vilmantasbaranauskas/n3d-crossed-cantilever-3d-printer/3d-models/README.md

### 3D Printable Models

This directory contains the 3D model files (`.3mf`) required to assemble the N3D Crossed-Cantilever 3D printer.

You will need a printer with a build plate of at least **220 × 220 mm** to print the parts.

### Gantry Configuration Options

The gantry component is provided in two options to accommodate different printer build volumes and user preferences. The minimum required bed size for printing the gantry as a single part is around **242 × 242 mm**.

* **Single Part:** `gantry-as-one-part.3mf`
* **Split into 3 Parts:** `gantry-left.3mf`, `gantry-center.3mf` and `gantry-right.3mf`
