vilmantasbaranauskas/n3d-crossed-cantilever-3d-printer/3d-models/timing-belt-holder-bottom.3mf

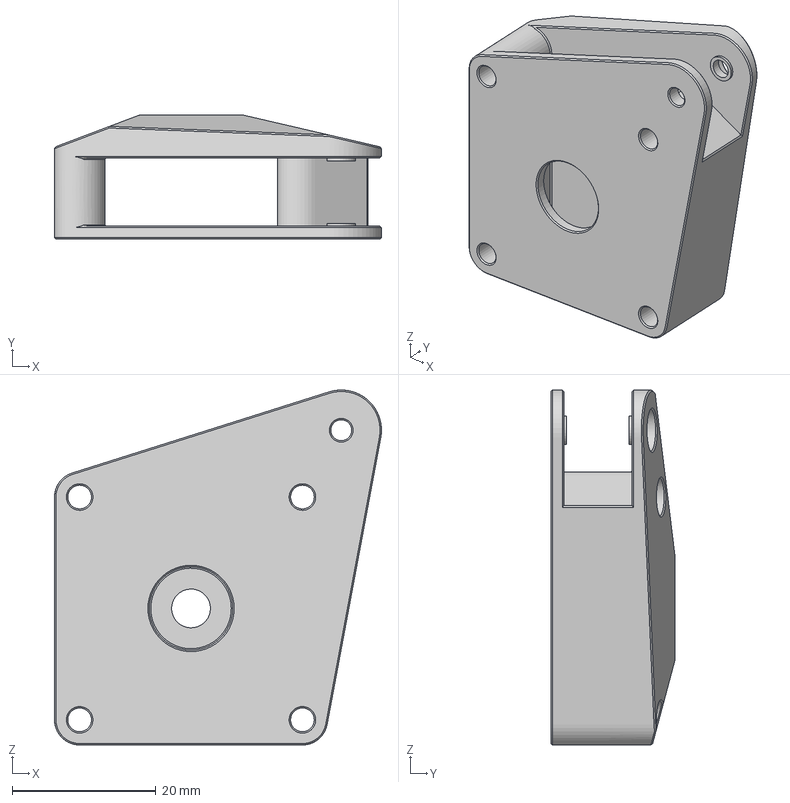
[picture p1: CAD file, 2026-11-01]
3d-models/timing-belt-holder-bottom.3mf
45.5 x 17.3 x 49.4 mm
