vilmantasbaranauskas/n3d-crossed-cantilever-3d-printer/cad/print-block.step

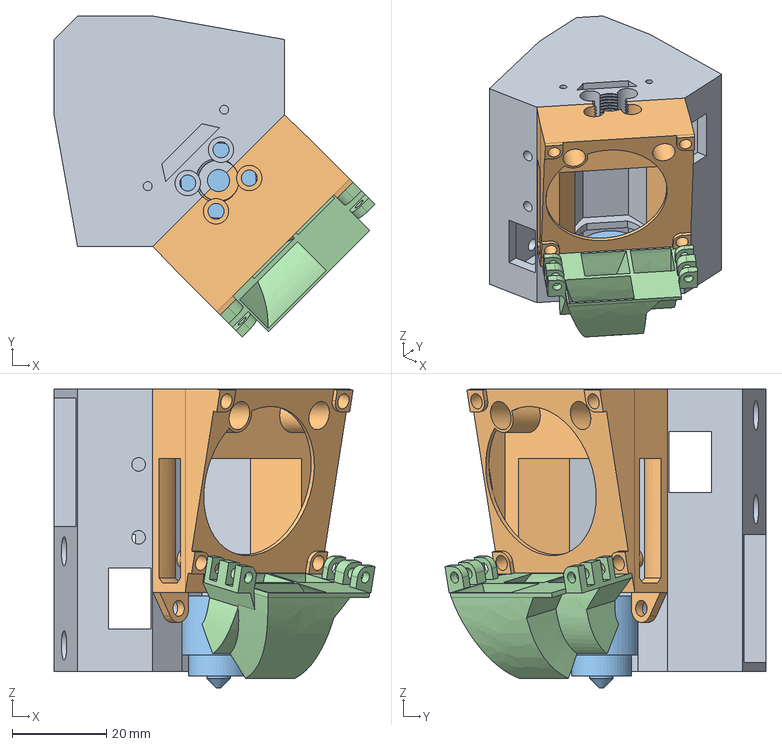
[picture p2: CAD file, 2026-10-28]
cad/print-block.step
68.3 x 68.3 x 63.5 mm
