vilmantasbaranauskas/n3d-crossed-cantilever-3d-printer/3d-models/gantry-as-one-part.3mf

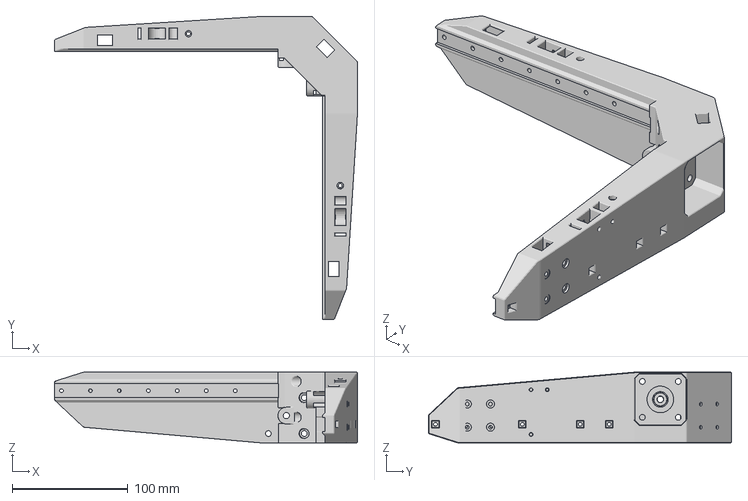
[picture p3: CAD file, 2026-10-28]
3d-models/gantry-as-one-part.3mf
261.5 x 261.5 x 61.0 mm
