vilmantasbaranauskas/n3d-crossed-cantilever-3d-printer/3d-models/belt-tensioner.3mf

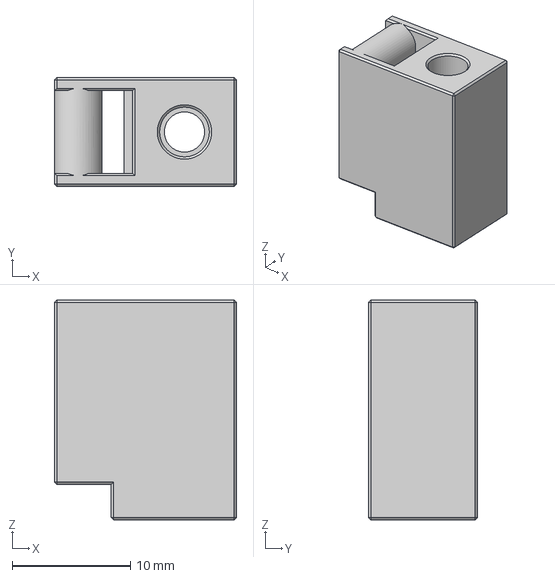
[picture p4: CAD file, 2026-10-28]
3d-models/belt-tensioner.3mf
15.4 x 9.20 x 18.6 mm
