vilmantasbaranauskas/n3d-crossed-cantilever-3d-printer/3d-models/m3-damper.3mf

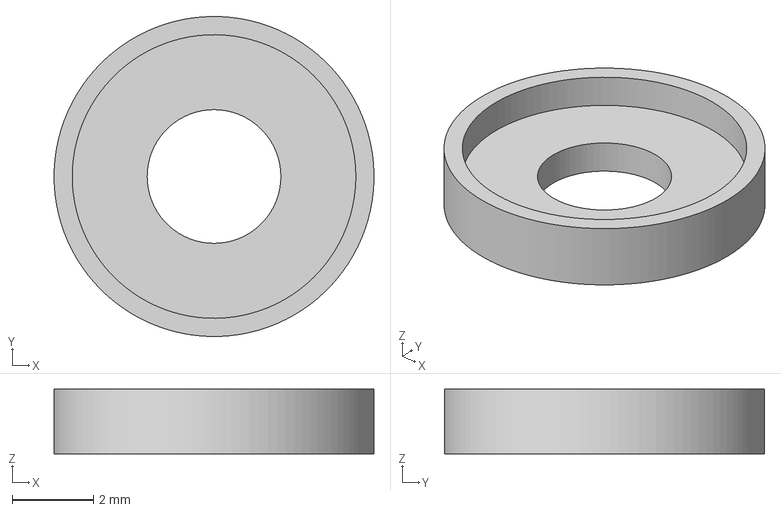
[picture p5: CAD file, 2026-10-28]
3d-models/m3-damper.3mf
7.90 x 7.90 x 1.60 mm
