vilmantasbaranauskas/n3d-crossed-cantilever-3d-printer/3d-models/gantry-left.3mf

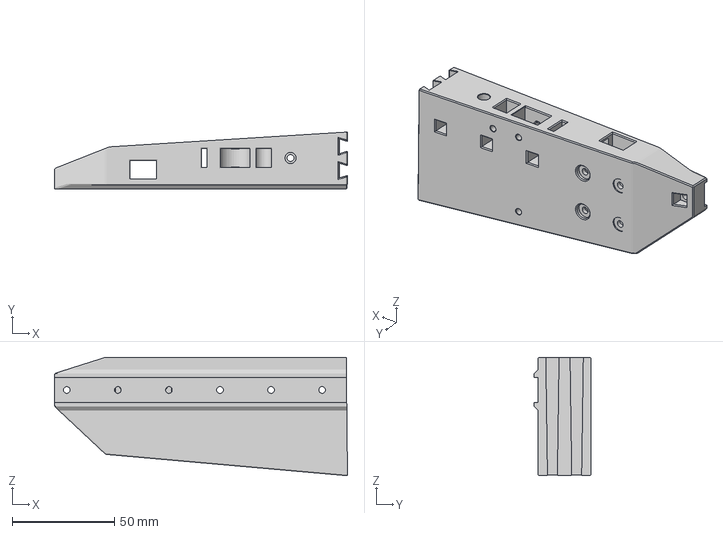
[picture p6: CAD file, 2026-10-28]
3d-models/gantry-left.3mf
143.4 x 27.9 x 58.0 mm
