vilmantasbaranauskas/n3d-crossed-cantilever-3d-printer/3d-models/gantry-center.3mf

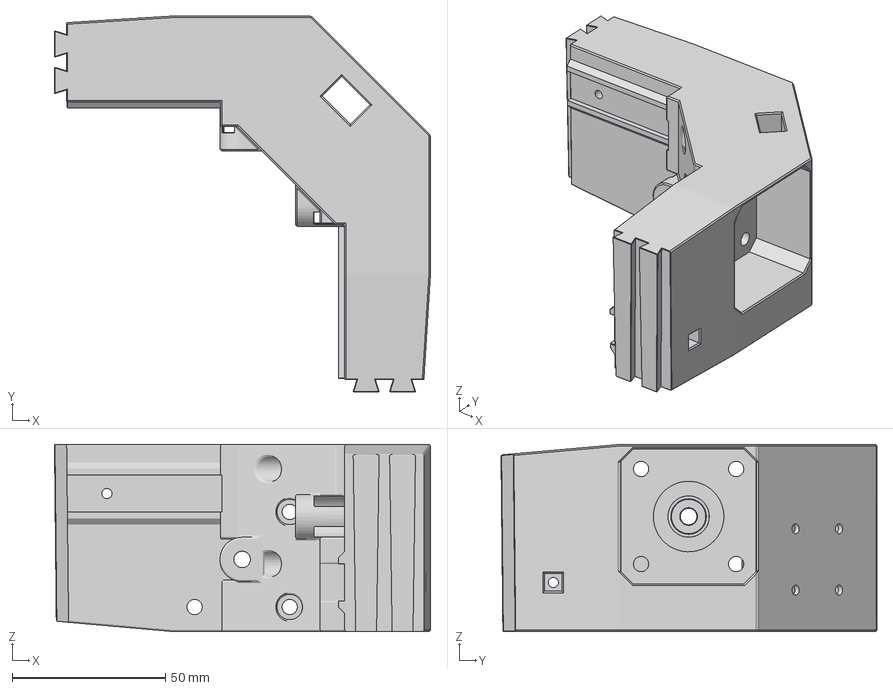
[picture p7: CAD file, 2026-10-28]
3d-models/gantry-center.3mf
122.6 x 122.6 x 61.0 mm
