vilmantasbaranauskas/n3d-crossed-cantilever-3d-printer/3d-models/hotbed-adapter.3mf

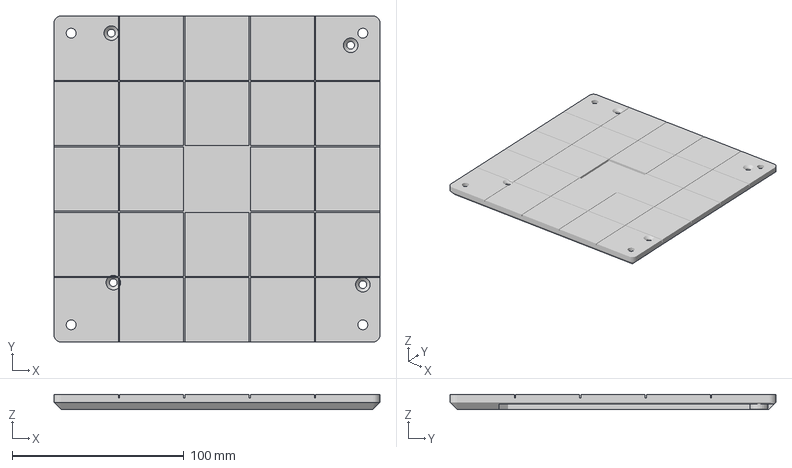
[picture p8: CAD file, 2026-10-28]
3d-models/hotbed-adapter.3mf
190.0 x 190.0 x 8.50 mm
