vilmantasbaranauskas/n3d-crossed-cantilever-3d-printer/3d-models/belt-tensioner-plug.3mf

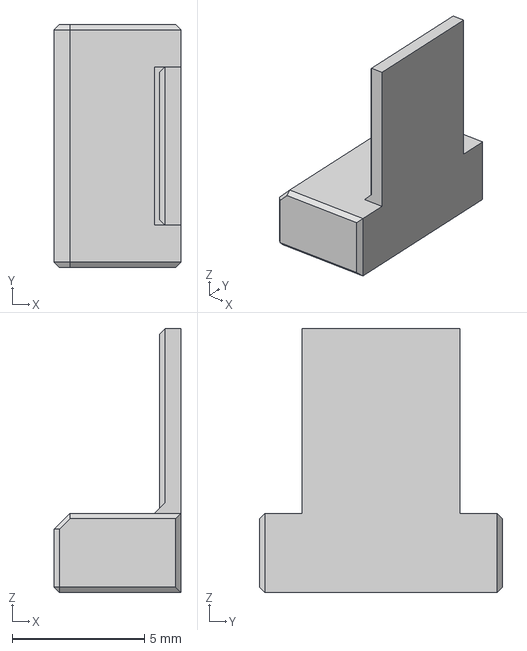
[picture p9: CAD file, 2026-10-28]
3d-models/belt-tensioner-plug.3mf
4.80 x 9.20 x 10.0 mm
