vilmantasbaranauskas/n3d-crossed-cantilever-3d-printer/3d-models/cover.3mf

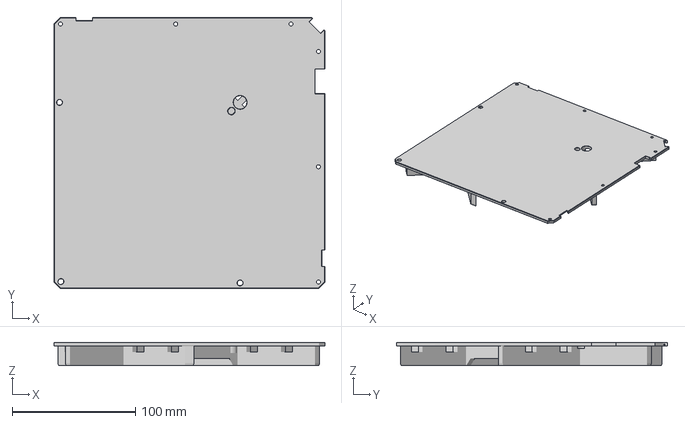
[picture p10: CAD file, 2026-10-28]
3d-models/cover.3mf
220.0 x 220.0 x 19.0 mm
