vilmantasbaranauskas/n3d-crossed-cantilever-3d-printer/3d-models/fan-damper.3mf

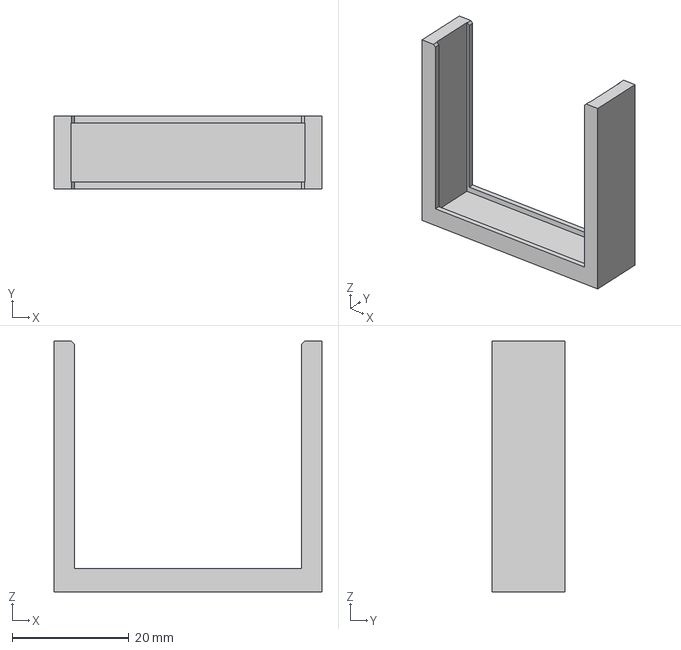
[picture p11: CAD file, 2026-10-28]
3d-models/fan-damper.3mf
46.0 x 12.5 x 43.0 mm
