vilmantasbaranauskas/n3d-crossed-cantilever-3d-printer/3d-models/transformer-holder.3mf

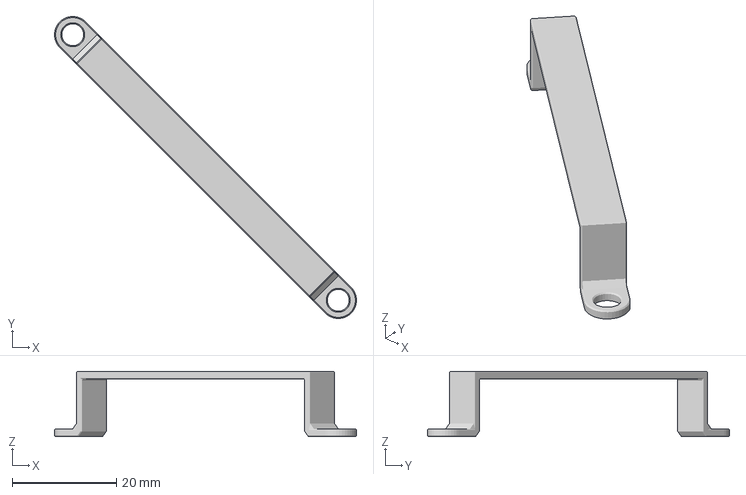
[picture p12: CAD file, 2026-10-28]
3d-models/transformer-holder.3mf
57.9 x 57.9 x 12.5 mm
