vilmantasbaranauskas/n3d-crossed-cantilever-3d-printer/3d-models/print-block-front-for-e3d-revo-voron.3mf

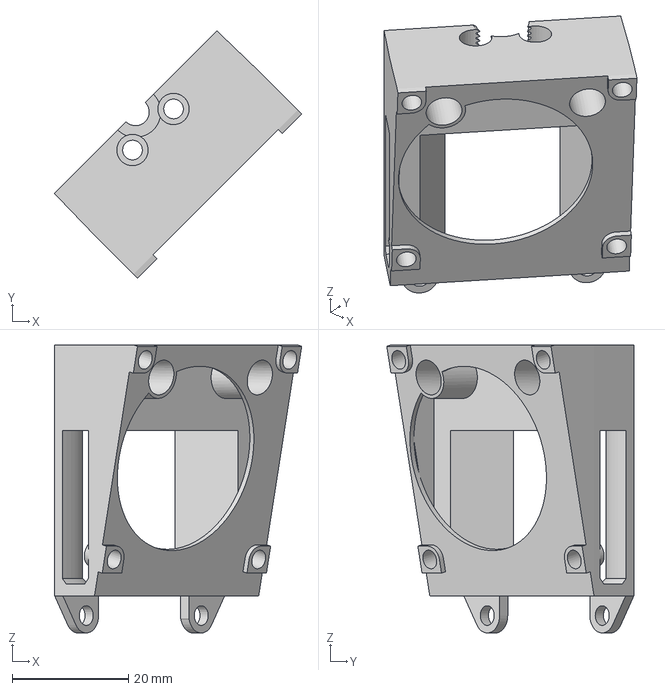
[picture p13: CAD file, 2026-10-28]
3d-models/print-block-front-for-e3d-revo-voron.3mf
42.6 x 42.6 x 49.6 mm
