vilmantasbaranauskas/n3d-crossed-cantilever-3d-printer/3d-models/nema17-damper-2.8-1.8mm.3mf

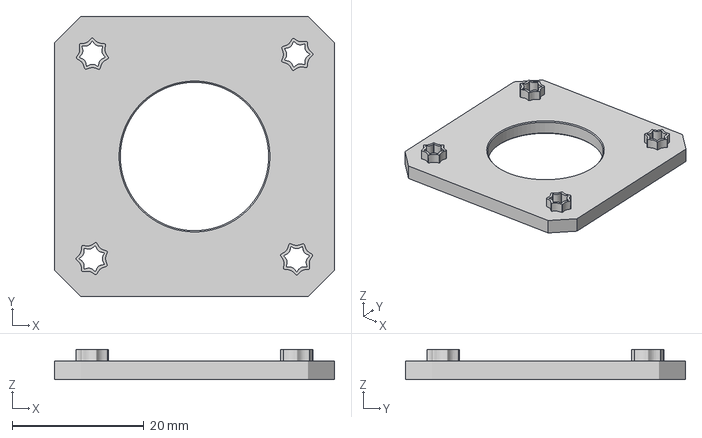
[picture p14: CAD file, 2026-10-28]
3d-models/nema17-damper-2.8-1.8mm.3mf
42.5 x 42.5 x 4.60 mm
