vilmantasbaranauskas/n3d-crossed-cantilever-3d-printer/3d-models/timing-belt-holder-bottom-damper.3mf

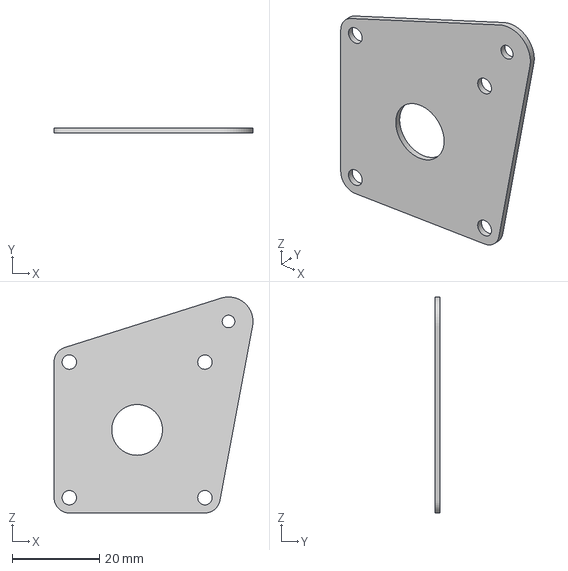
[picture p15: CAD file, 2026-10-28]
3d-models/timing-belt-holder-bottom-damper.3mf
45.5 x 1.20 x 49.4 mm
