vilmantasbaranauskas/n3d-crossed-cantilever-3d-printer/3d-models/gt2-16t.3mf

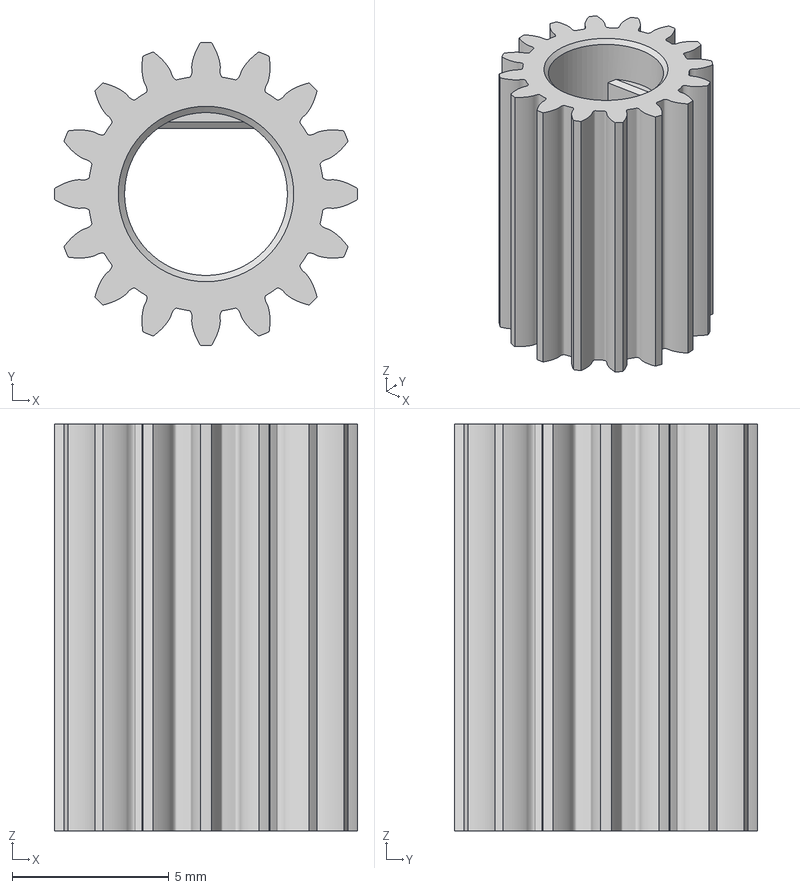
[picture p16: CAD file, 2026-10-28]
3d-models/gt2-16t.3mf
9.68 x 9.68 x 13.0 mm
