vilmantasbaranauskas/n3d-crossed-cantilever-3d-printer/3d-models/fan-duct-simple.3mf

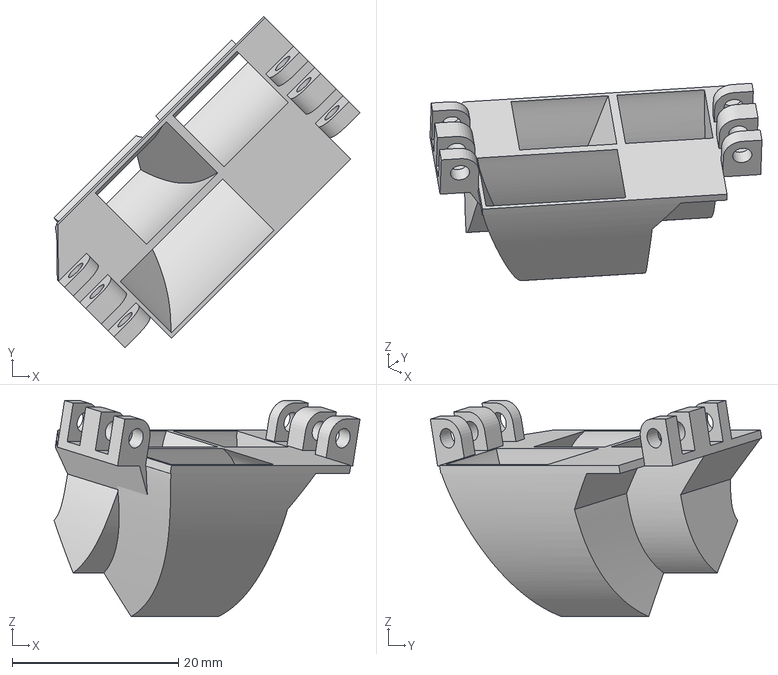
[picture p17: CAD file, 2026-10-28]
3d-models/fan-duct-simple.3mf
36.8 x 39.9 x 26.0 mm
