vilmantasbaranauskas/n3d-crossed-cantilever-3d-printer/3d-models/timing-belt-holder-xy.3mf

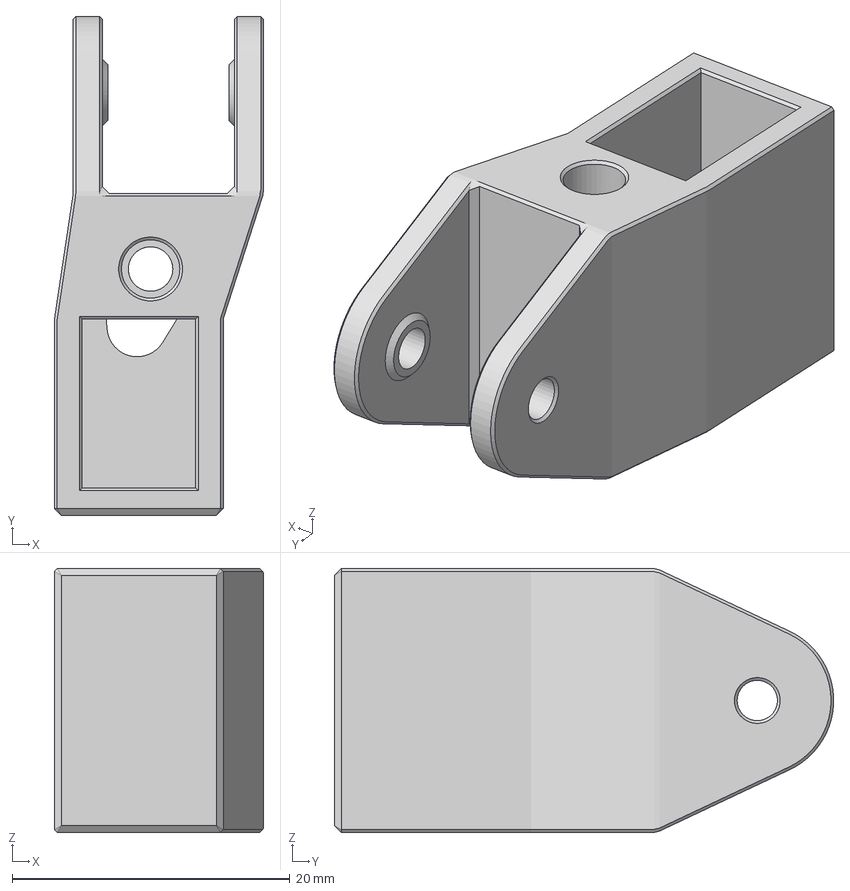
[picture p18: CAD file, 2026-10-28]
3d-models/timing-belt-holder-xy.3mf
15.1 x 35.9 x 19.0 mm
