vilmantasbaranauskas/n3d-crossed-cantilever-3d-printer/3d-models/print-block-for-e3d-revo-voron.3mf

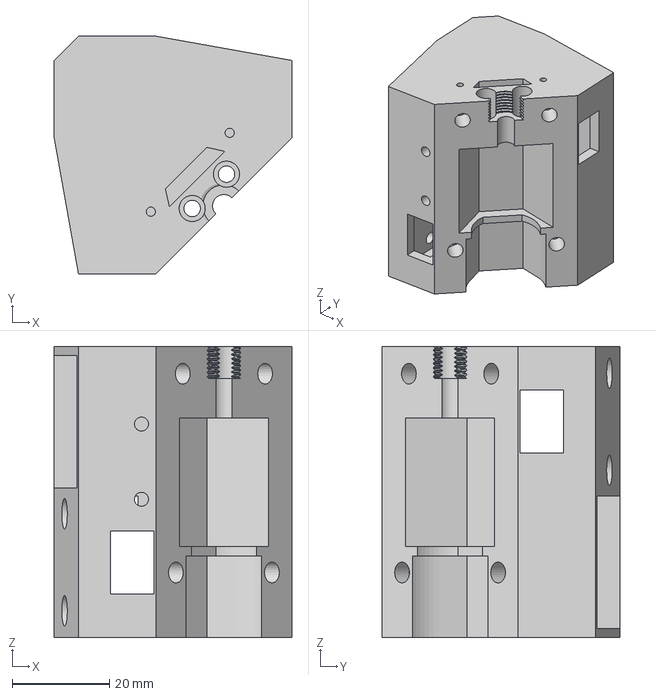
[picture p19: CAD file, 2026-10-28]
3d-models/print-block-for-e3d-revo-voron.3mf
49.0 x 49.0 x 60.0 mm
