vilmantasbaranauskas/n3d-crossed-cantilever-3d-printer/3d-models/belt-holder-top.3mf

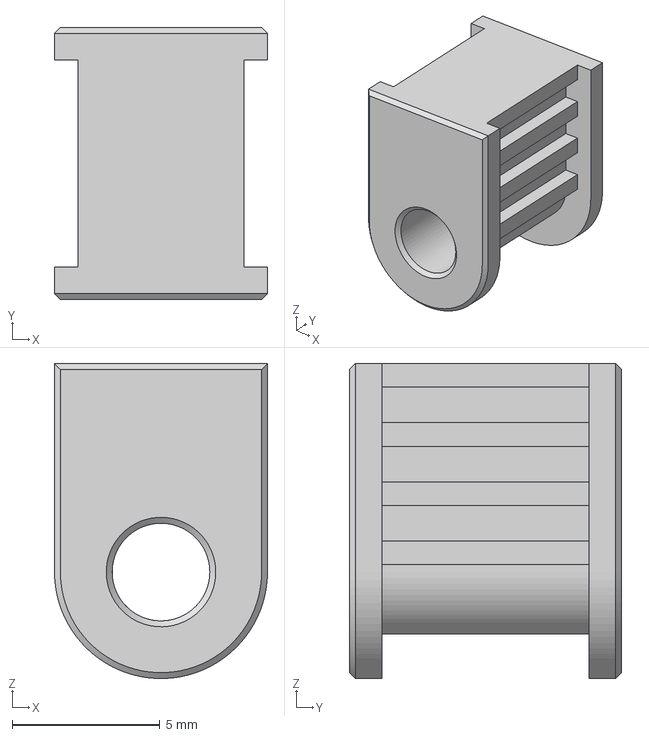
[picture p20: CAD file, 2026-10-28]
3d-models/belt-holder-top.3mf
7.20 x 9.20 x 10.6 mm
