vilmantasbaranauskas/n3d-crossed-cantilever-3d-printer/3d-models/gt2-15t.3mf

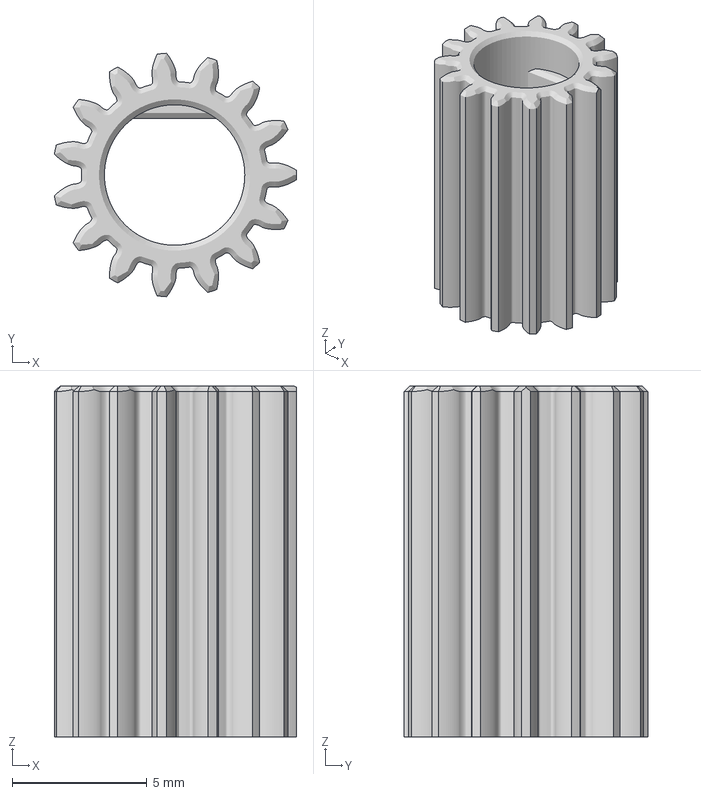
[picture p21: CAD file, 2026-10-28]
3d-models/gt2-15t.3mf
8.98 x 9.02 x 13.0 mm
