vilmantasbaranauskas/n3d-crossed-cantilever-3d-printer/3d-models/top-frame.3mf

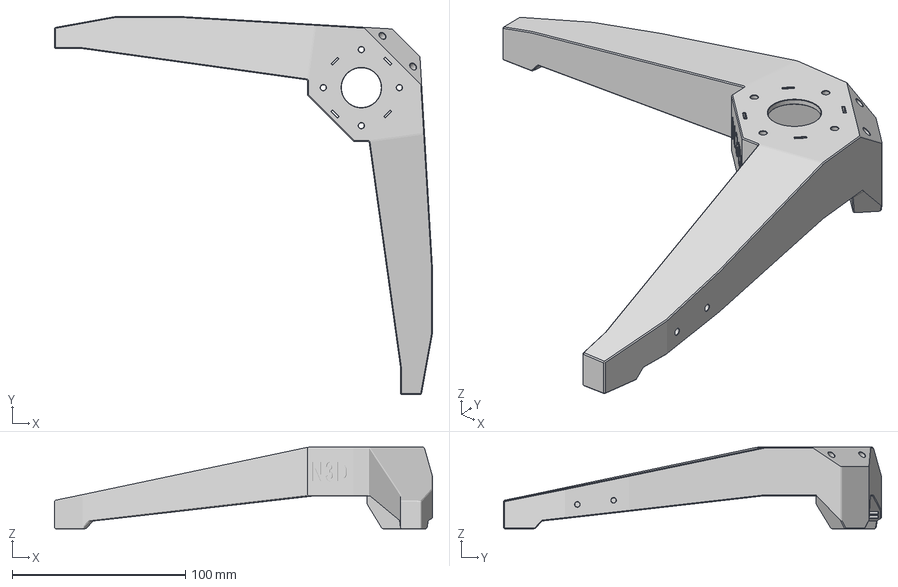
[picture p22: CAD file, 2026-10-28]
3d-models/top-frame.3mf
218.0 x 218.0 x 47.0 mm
