vilmantasbaranauskas/n3d-crossed-cantilever-3d-printer/3d-models/gt2-plug.3mf

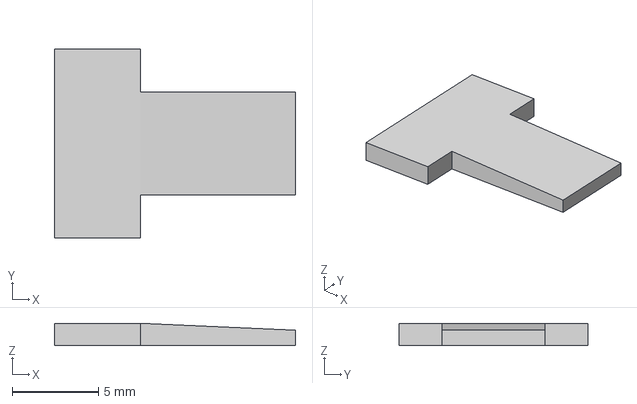
[picture p23: CAD file, 2026-10-28]
3d-models/gt2-plug.3mf
14.0 x 11.0 x 1.30 mm
