vilmantasbaranauskas/n3d-crossed-cantilever-3d-printer/3d-models/gantry-xy-lr-0.3mf

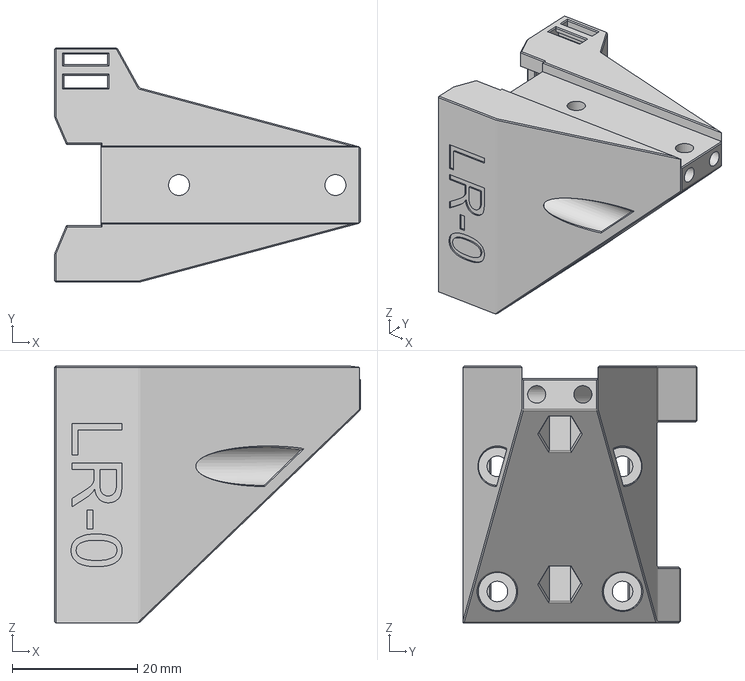
[picture p24: CAD file, 2026-10-28]
3d-models/gantry-xy-lr-0.3mf
48.9 x 37.4 x 41.0 mm
