vilmantasbaranauskas/n3d-crossed-cantilever-3d-printer/3d-models/base.3mf

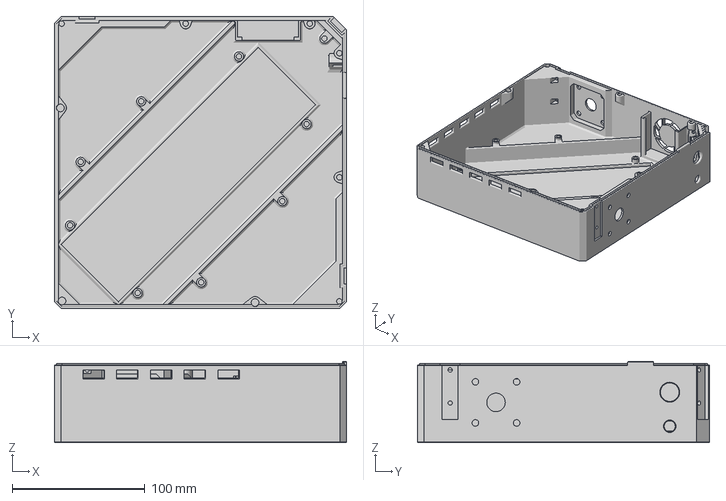
[picture p25: CAD file, 2026-10-28]
3d-models/base.3mf
220.0 x 220.0 x 61.4 mm
