vilmantasbaranauskas/n3d-crossed-cantilever-3d-printer/3d-models/timing-belt-holder-xy-tentioner.3mf

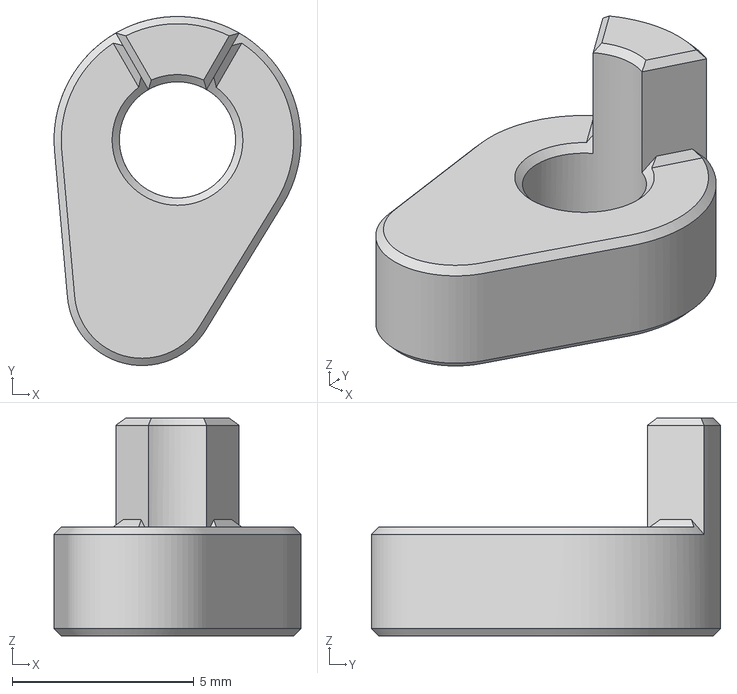
[picture p26: CAD file, 2026-10-28]
3d-models/timing-belt-holder-xy-tentioner.3mf
6.80 x 9.61 x 6.00 mm
