vilmantasbaranauskas/n3d-crossed-cantilever-3d-printer/(list of files, cad)

Other CAD files:
3d-models/gantry-right.3mf
3d-models/washer-3mm.3mf
