vilmantasbaranauskas/n3d-crossed-cantilever-3d-printer/3d-models/CHANGELOG.md

### 3D Models Changelog

All notable changes, model fixes, and revisions for the printable 3D models are documented in this file.

### 2026-11-01
- **Fixed**: `timing-belt-holder-bottom.3mf` broken model issue in Beta 1.

### Beta 1 - 2026-10-27
- Initial release of Beta 1 printable 3D models.
