vilmantasbaranauskas/n3d-crossed-cantilever-3d-printer/klipper-manta-m5p/printer.cfg

[include mainsail.cfg]

# host MCU service is preinstalled and ready to use with:
[mcu CB1]
serial: /tmp/klipper_host_mcu

[include generic-bigtreetech-manta-m5p.cfg]
#[include adxl.cfg]

[gcode_macro SMARTHOME]
gcode:
    {% if printer.toolhead.homed_axes == "xyz" %}
        M118 Printer is already homed
        G1 Z5 F2500
    {% else %}
        M118 Printer needs homed...
        G28
    {% endif %}


#*# <---------------------- SAVE_CONFIG ---------------------->
#*# DO NOT EDIT THIS BLOCK OR BELOW. The contents are auto-generated.
#*#
#*# [input_shaper]
#*# shaper_type_x = ei
#*# shaper_freq_x = 54.4
#*# shaper_type_y = ei
#*# shaper_freq_y = 51.8
#*# shaper_type_z = mzv
#*# shaper_freq_z = 42.0
