vilmantasbaranauskas/n3d-crossed-cantilever-3d-printer/(commit log)

2026-10-28 Initial release of beta 1.
    [base.3mf, belt-holder-top.3mf, belt-tensioner-plug.3mf, belt-tensioner.3mf, cover.3mf, fan-damper.3mf, fan-duct-simple.3mf, gantry-center.3mf]
2026-10-28 Removed duplicate empty BOM.md
2026-10-28 Added klipper configuration for manta m5p as-is (wip).
    [generic-bigtreetech-manta-m5p.cfg, printer.cfg]
2026-10-28 Minor klipper configuration clean-up.
    [generic-bigtreetech-manta-m5p.cfg]
2026-10-28 Take over some printer parameters from klipper to README.md
2026-10-28 Renamed parts to 3d-models, dropped duplicate LICENSE.md file.
    [base.3mf, belt-holder-top.3mf, belt-tensioner-plug.3mf, belt-tensioner.3mf, cover.3mf, fan-damper.3mf, fan-duct-simple.3mf, gantry-center.3mf]
2026-10-28 Added gantry-as-one-part 3D model.
    [gantry-as-one-part.3mf]
2026-10-28 Added README.md for 3D models detailing gantry configuration options.
2026-10-28 Documented build plate size requirement in README and 3D models README
2026-10-29 Added ADXL klipper configuration.
    [adxl.cfg]
2026-10-30 Removed unused and duplicate ADXL345 configuration from Manta M5P configuration file.
    [generic-bigtreetech-manta-m5p.cfg]
2026-10-31 Documented gantry size requirements.
2026-11-01 Fixed timing-belt-holder-bottom.3mf broken model issue in Beta 1.
    [timing-belt-holder-bottom.3mf]
